Lautaro-De-Lucia/doc-final-electroacustica/Fuentes/Electroacústica_Completo-284-322.pdf

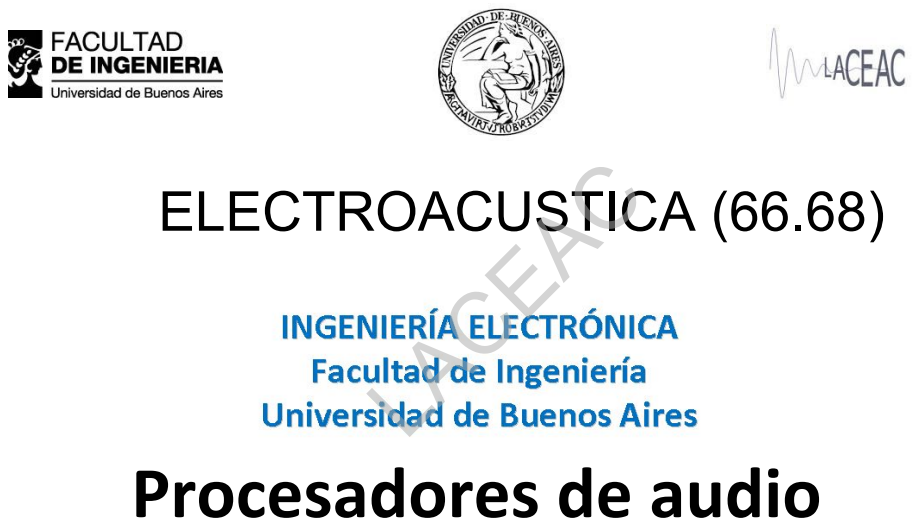
[picture p139: page 1]
ELECTROACUSTICA (66.68); LACEAC

# Gain

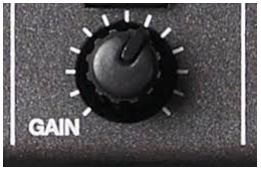
[picture p140: figure]
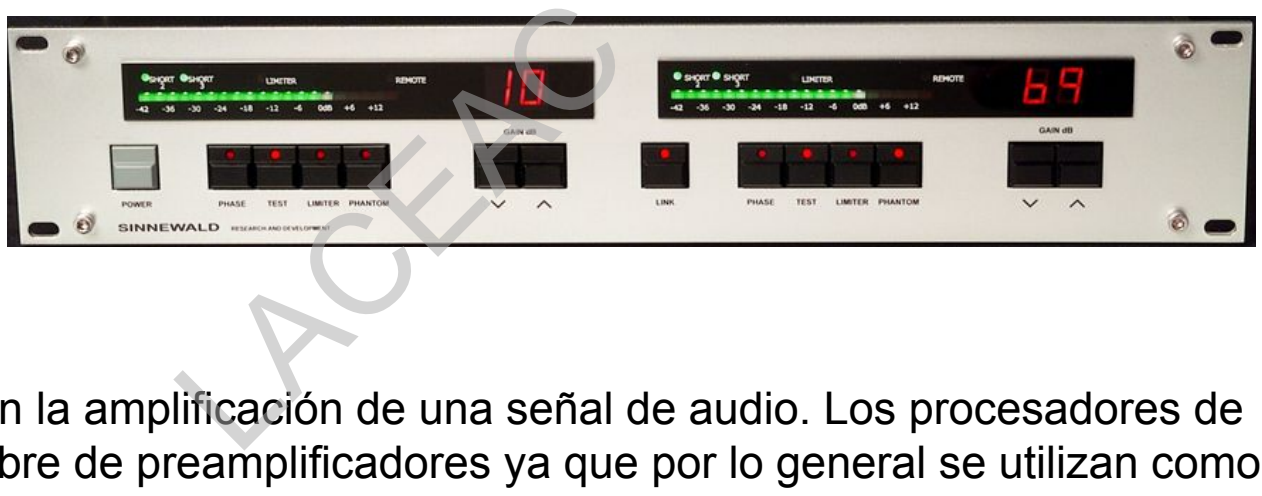
[picture p141: figure]
LACEAC

Consiste simplemente en la amplificación de una señal de audio. Los procesadores de este tipo reciben el nombre de preamplificadores ya que por lo general se utilizan como inicio de la cadena de audio para obtener el nivel de señal de deseado para su posterior procesamiento. Debe tenerse en cuenta que debido a que no existe el amplificador ideal, este proceso introducirá indefectiblemente distorsión armónica y ruido en la señal.

# Suma o “Mezcla”

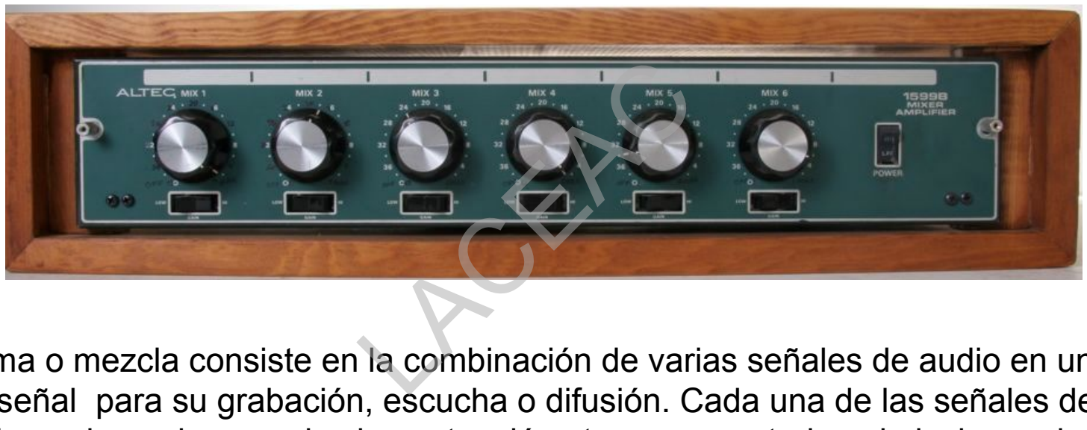
[picture p142: figure]
LACEAC

La suma o mezcla consiste en la combinación de varias señales de audio en una única señal para su grabación, escucha o difusión. Cada una de las señales de entrada se denomina canal, y los potenciómetros que controlan el nivel con el que se suma a la señal de salida se denominan faders. En el caso de una señal de salida stereo mediante un potenciómetro llamado pan también se controla el nivel enviado a cada canal de salida para controlar la imagen virtual generada.

# Suma o “Mezcla”

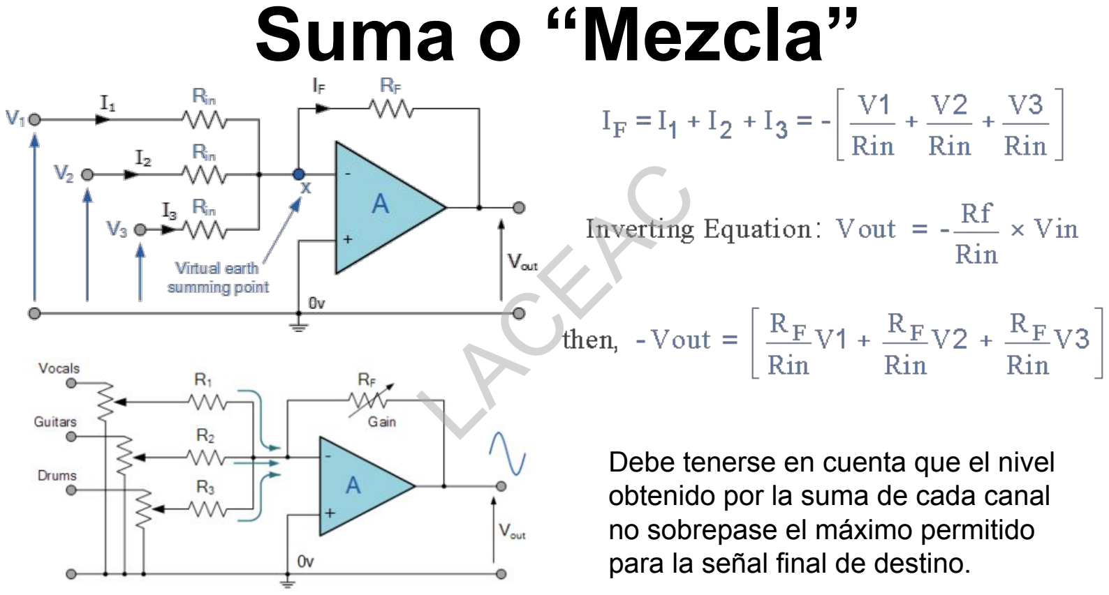
[picture p143: page 4]

Debe tenerse en cuenta que el nivel obtenido por la suma de cada canal no sobrepase el máximo permitido para la señal final de destino.

# LACEAC

# Suma o “Mezcla”

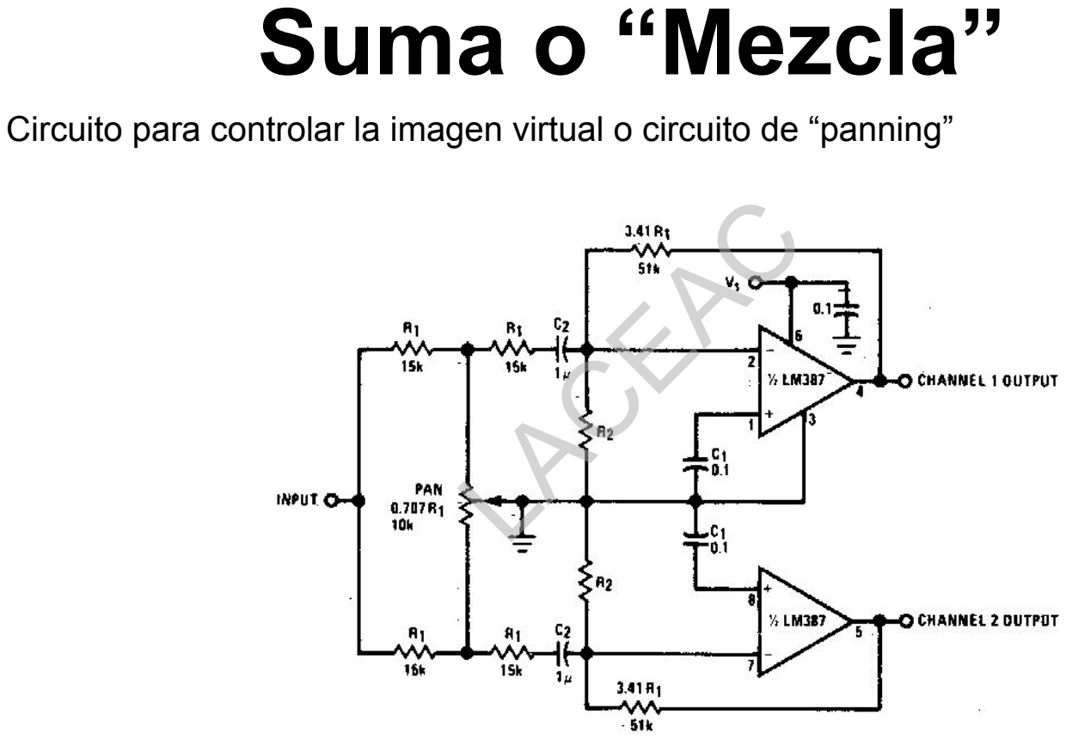
[picture p144: page 5]

Circuito para controlar la imagen virtual o circuito de “panning”

# LACEAC

EQ

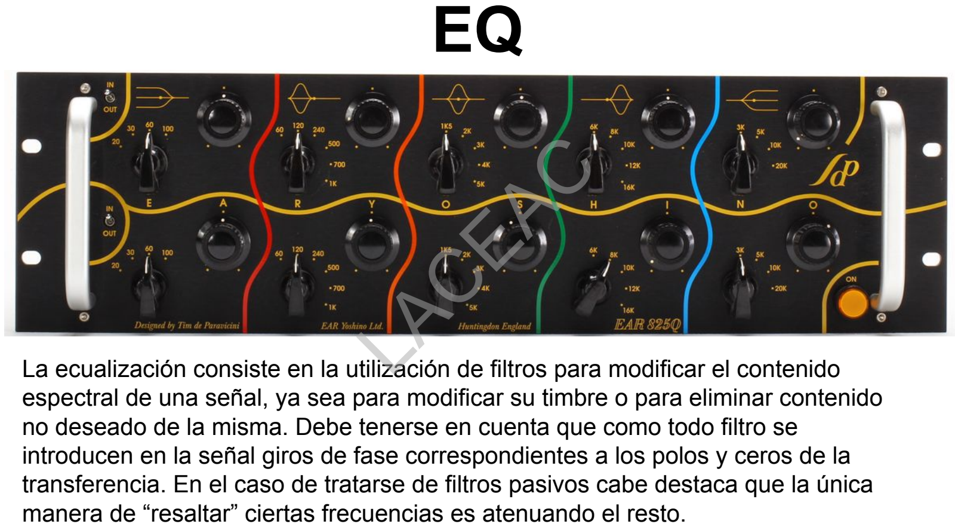
[picture p145: page 6]

La ecualización consiste en la utilización de filtros para modificar el contenido espectral de una señal, ya sea para modificar su timbre o para eliminar contenido no deseado de la misma. Debe tenerse en cuenta que como todo filtro se introducen en la señal giros de fase correspondientes a los polos y ceros de la transferencia. En el caso de tratarse de filtros pasivos cabe destaca que la única manera de “resaltar” ciertas frecuencias es atenuando el resto.

# LACEAC

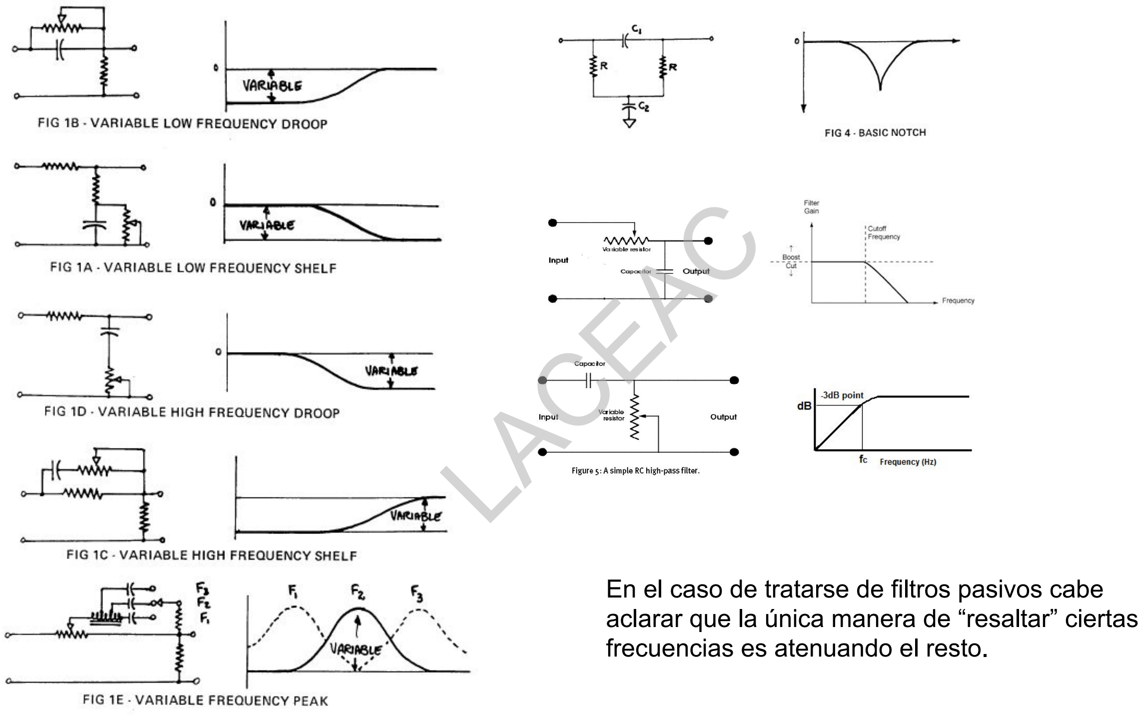
[picture p146: page 7]

En el caso de tratarse de filtros pasivos cabe aclarar que la única manera de “resaltar” ciertas frecuencias es atenuando el resto.

# LACEAC

# Ecualizador paramétrico

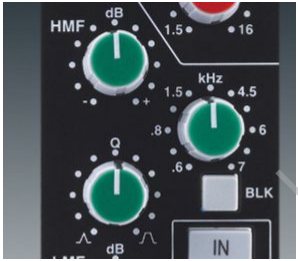
[picture p147: figure]

En un ecualizador paramétrico la frecuencia de corte, la ganancia y factor de mérito son variables. Por limitaciones constructivas el rango de operación suele ser limitado.

# LACEAC

# Ecualizador paramétrico

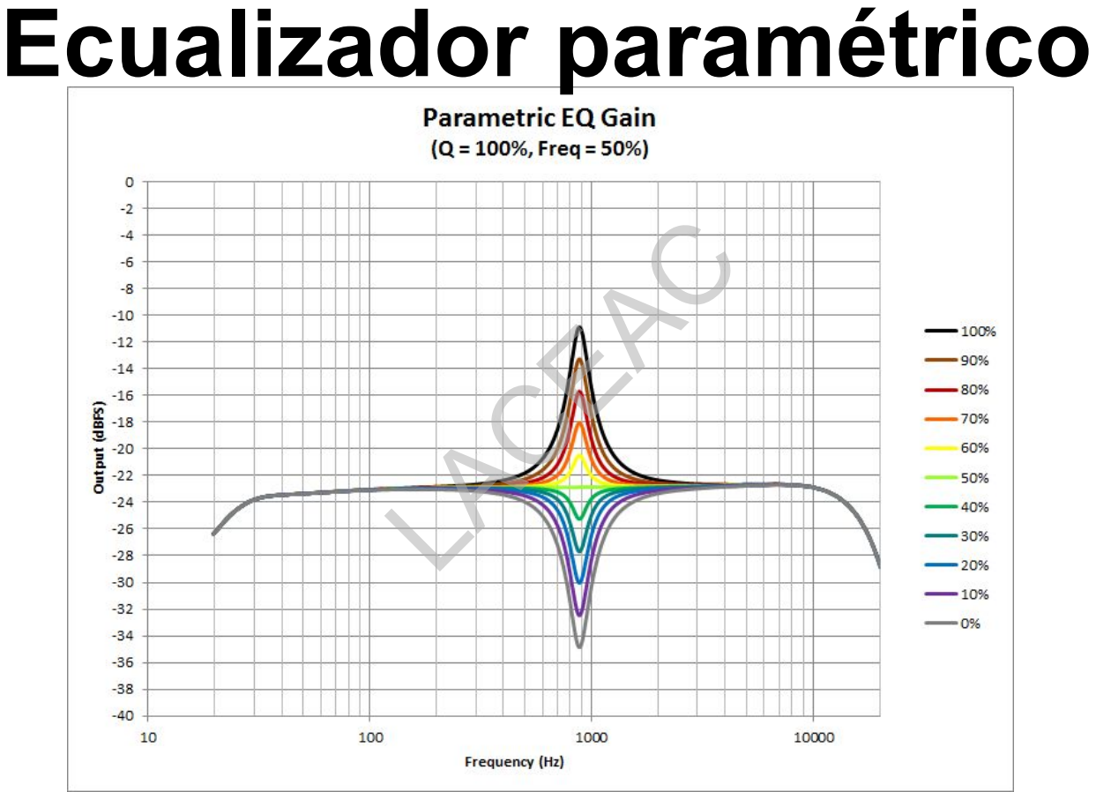
[picture p148: page 9]

# LACEAC

# Ecualizador paramétrico

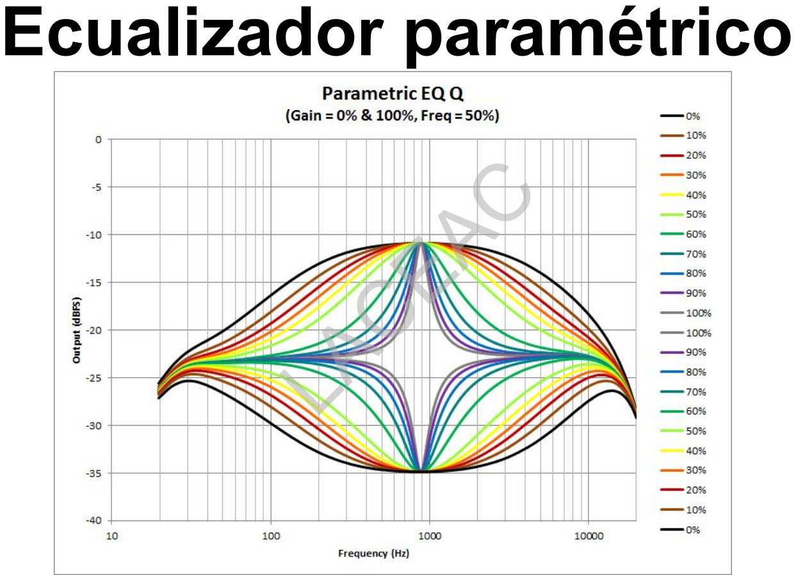
[picture p149: page 10]

# LACEAC

# Ecualizador paramétrico

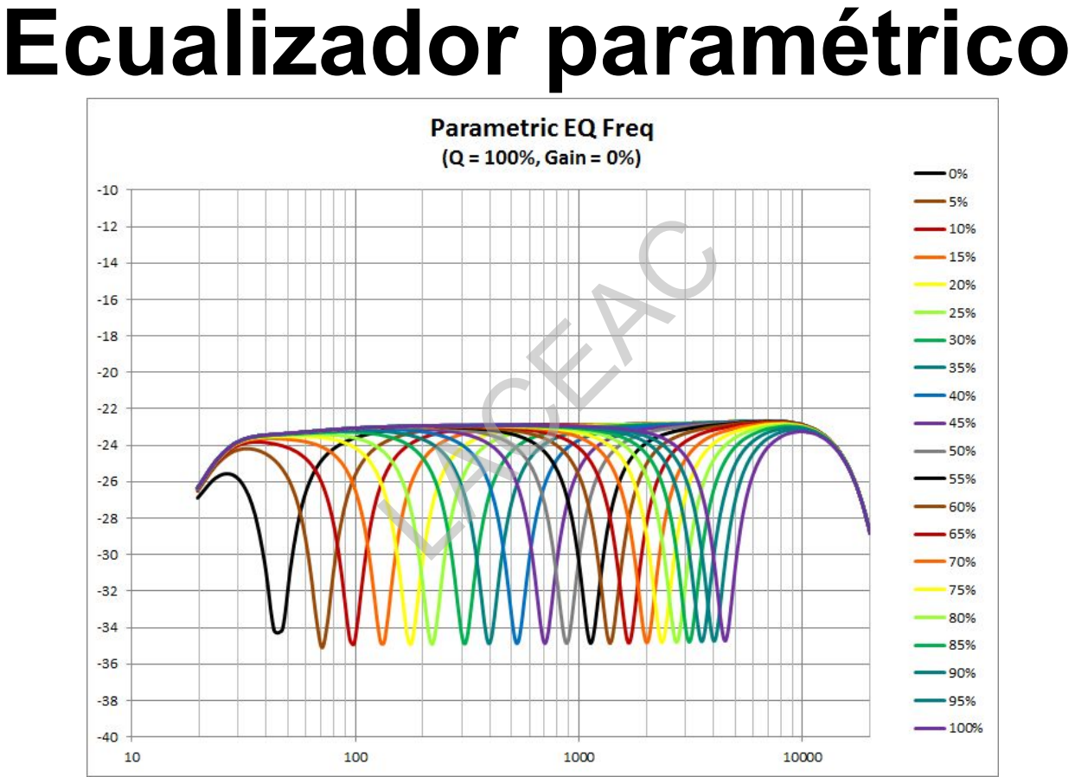
[picture p150: page 11]

# LACEAC

# Wah-Wah

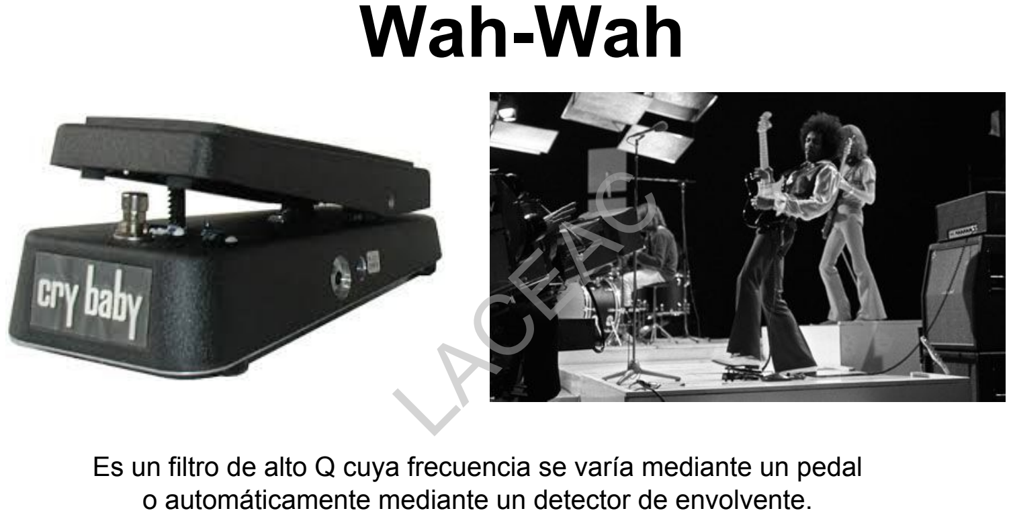
[picture p151: page 12]

Es un filtro de alto Q cuya frecuencia se varía mediante un pedal o automáticamente mediante un detector de envolvente.

# LACEAC

# Ecualizador Gráfico

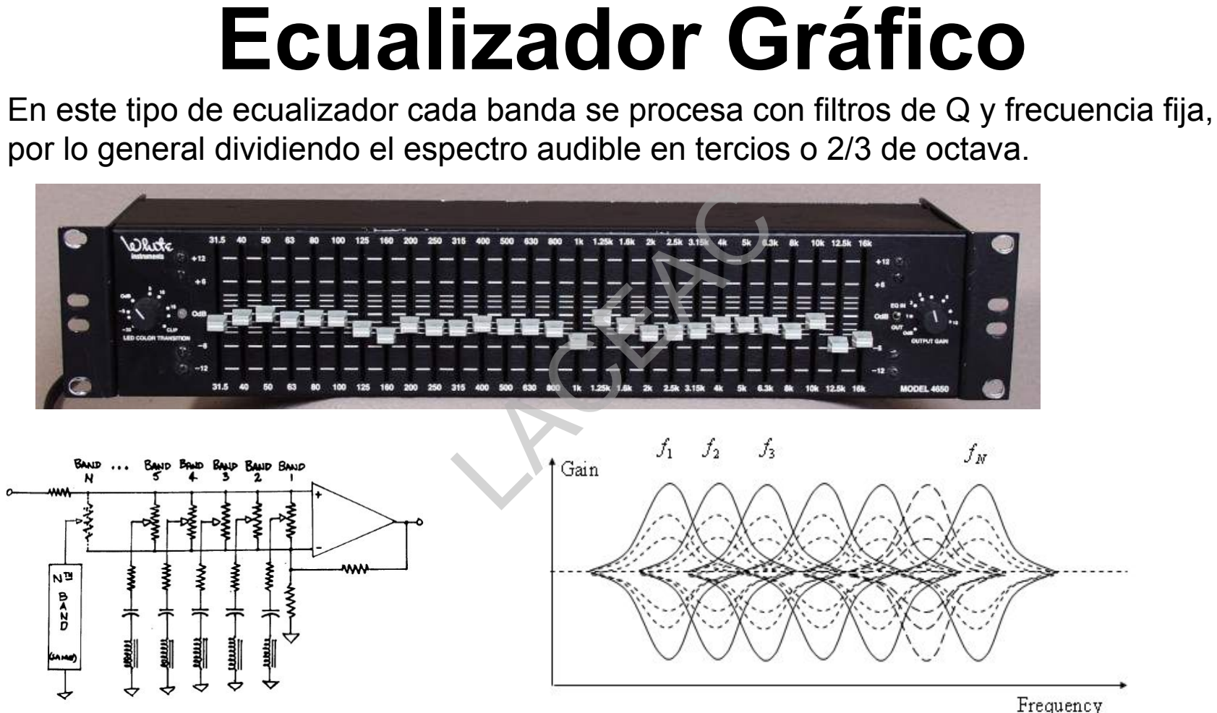
[picture p152: page 13]

En este tipo de ecualizador cada banda se procesa con filtros de Q y frecuencia fija, por lo general dividiendo el espectro audible en tercios o 2/3 de octava.

# LACEAC

# Consola o mixer

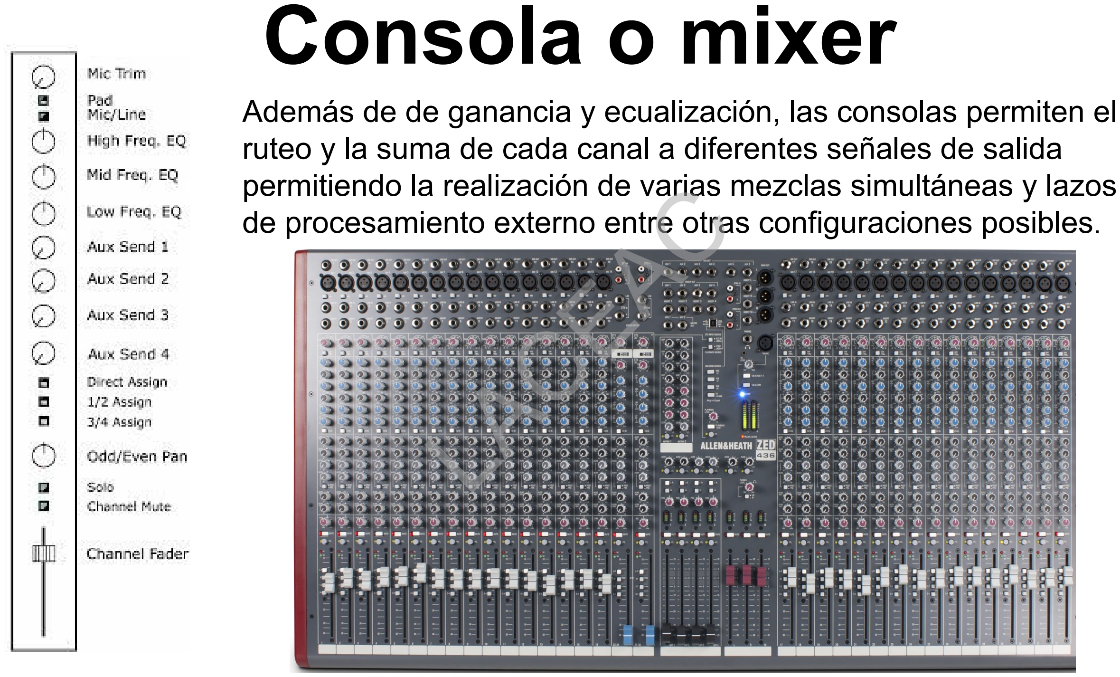
[picture p153: page 14]

Además de de ganancia y ecualización, las consolas permiten el ruteo y la suma de cada canal a diferentes señales de salida permitiendo la realización de varias mezclas simultáneas y lazos de procesamiento externo entre otras configuraciones posibles.

# LACEAC

El efecto de chorus es un proceso de modulación que emula el pequeño movimiento en tiempo y afinación que se genera entre 2 o más ejecutantes de un coro cantando al unísono.Para generar este efecto a la señal original se le suma una copia con un delay variable modulado por un LFO de aproximadamente 5 a 40 ms . El delay está implementado mediante la modulación de la frecuencia de clock de una línea de retardo analógica mediante el uso de celdas BBD (bucket brigade device) de manera que las pequeñas variaciones de delay también introducen variaciones de afinación.

# Chorus

# LACEAC

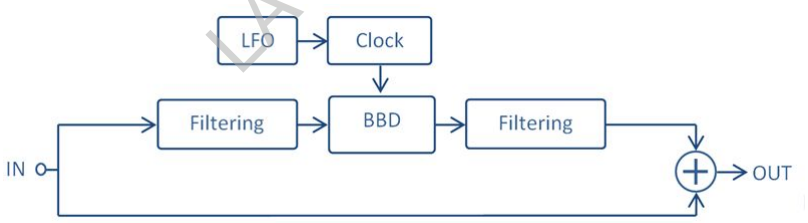
[picture p154: figure]

# Flanger

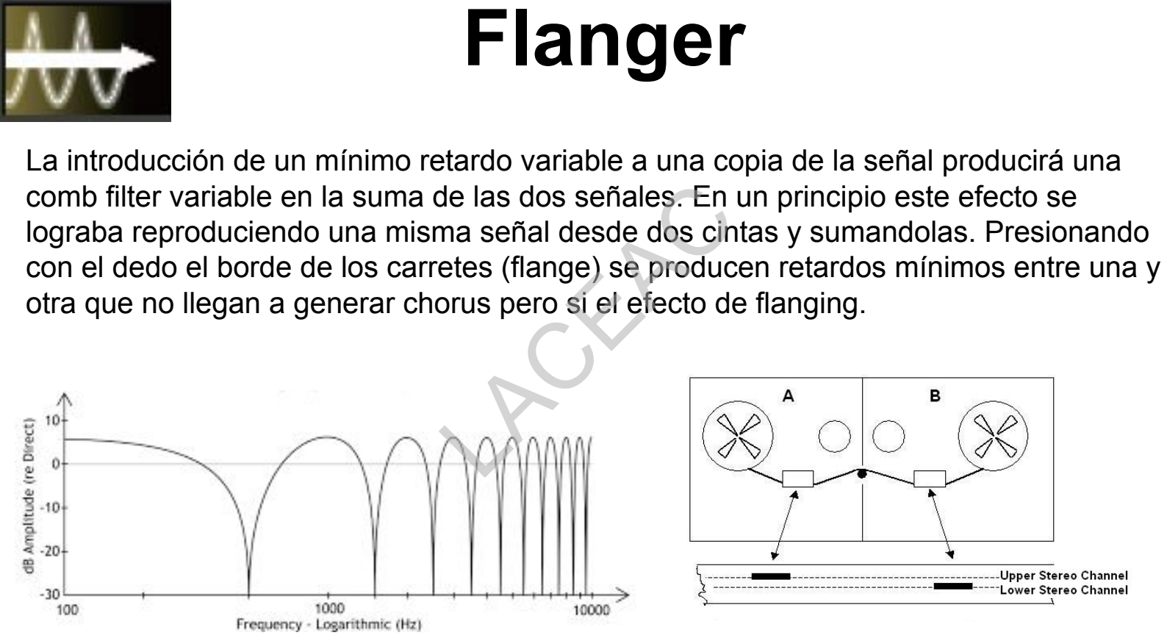
[picture p155: page 16]

La introducción de un mínimo retardo variable a una copia de la señal producirá una comb filter variable en la suma de las dos señales. En un principio este efecto se lograba reproduciendo una misma señal desde dos cintas y sumandolas. Presionando con el dedo el borde de los carretes (flange) se producen retardos mínimos entre una y otra que no llegan a generar chorus pero si el efecto de flanging.

# LACEAC

# Flanger

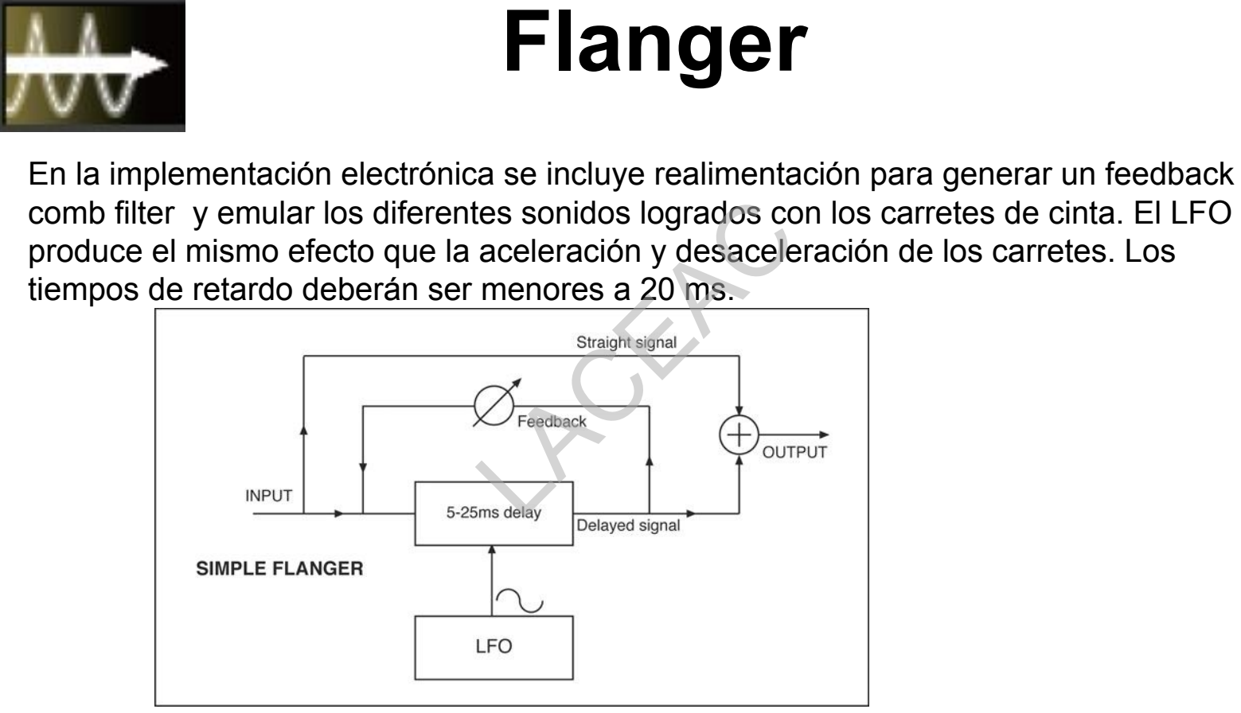
[picture p156: page 17]

En la implementación electrónica se incluye realimentación para generar un feedback comb filter y emular los diferentes sonidos logrados con los carretes de cinta. El LFO produce el mismo efecto que la aceleración y desaceleración de los carretes. Los tiempos de retardo deberán ser menores a 20 ms.

# LACEAC

# Phaser

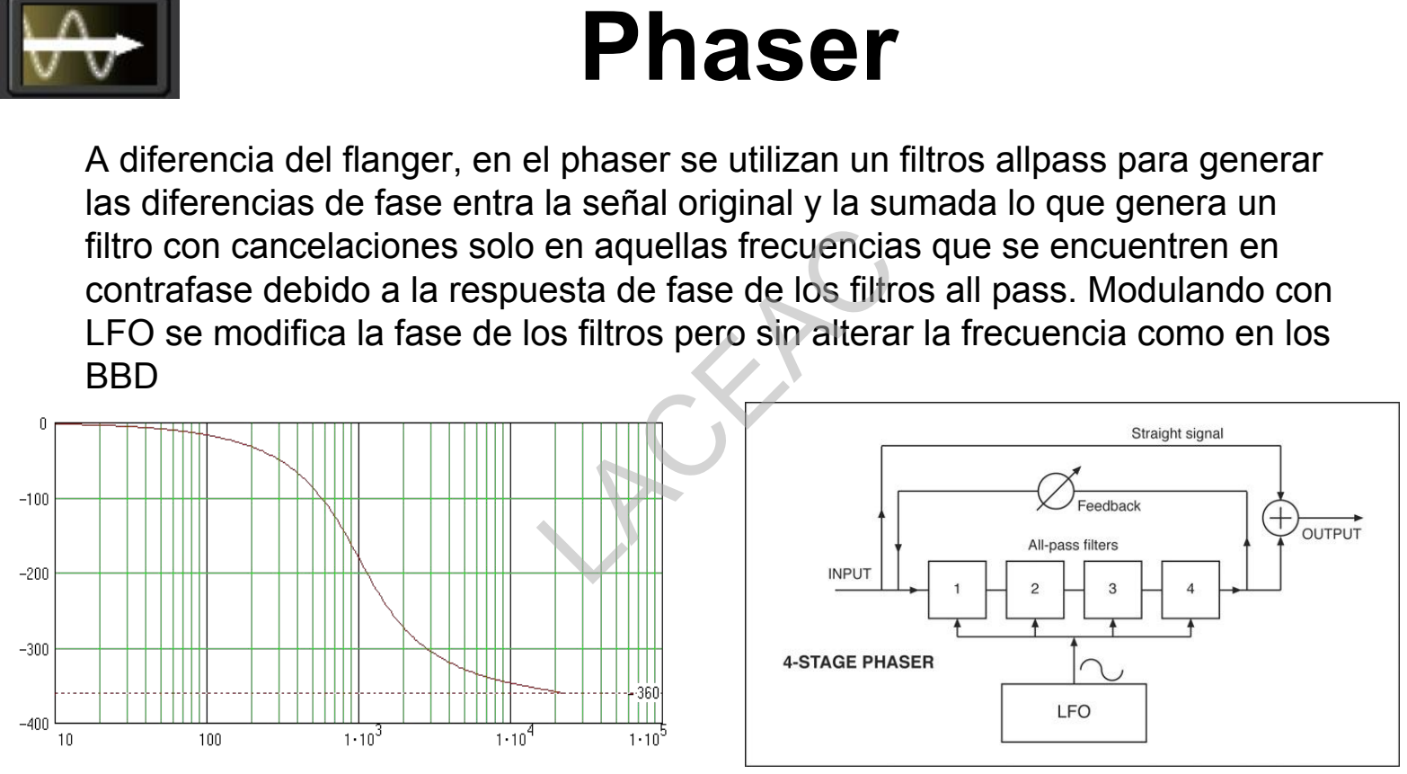
[picture p157: page 18]

A diferencia del flanger, en el phaser se utilizan un filtros allpass para generar las diferencias de fase entra la señal original y la sumada lo que genera un filtro con cancelaciones solo en aquellas frecuencias que se encuentren en contrafase debido a la respuesta de fase de los filtros all pass. Modulando con LFO se modifica la fase de los filtros pero sin alterar la frecuencia como en los BBD

# LACEAC

# Phaser

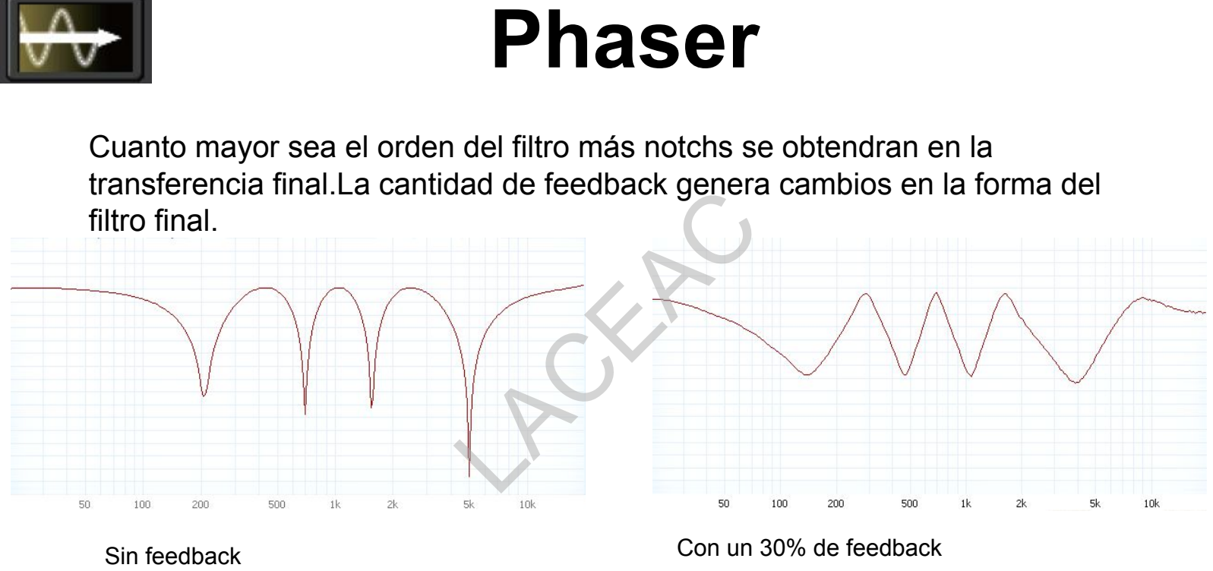
[picture p158: page 19]

Cuanto mayor sea el orden del filtro más notchs se obtendran en la transferencia final.La cantidad de feedback genera cambios en la forma del filtro final.

Sin feedback | Con un 30% de feedback

# LACEAC

# Reverb

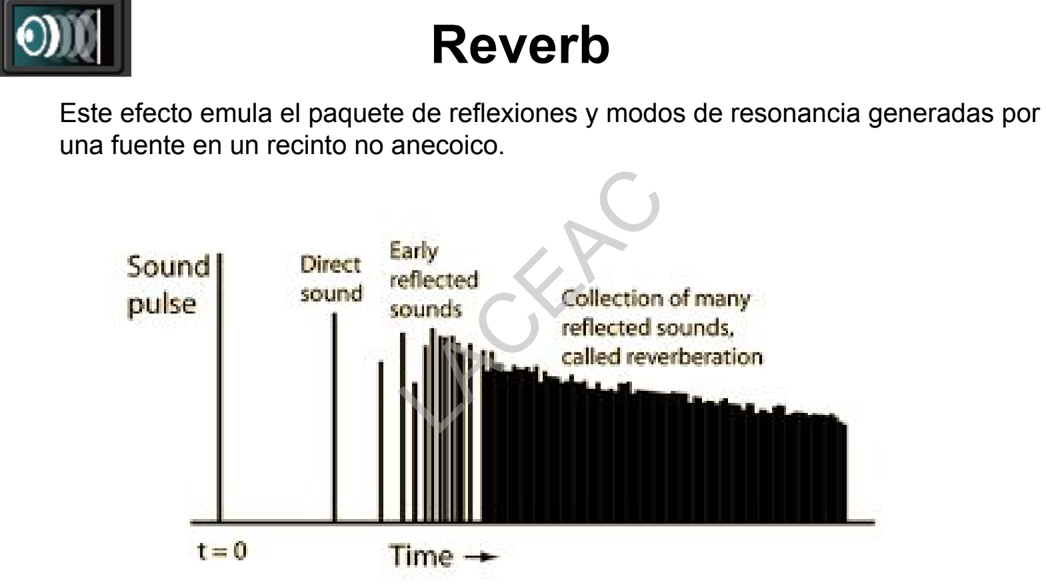
[picture p159: page 20]

Este efecto emula el paquete de reflexiones y modos de resonancia generadas por una fuente en un recinto no anecoico.

# LACEAC

# Reverb Chamber

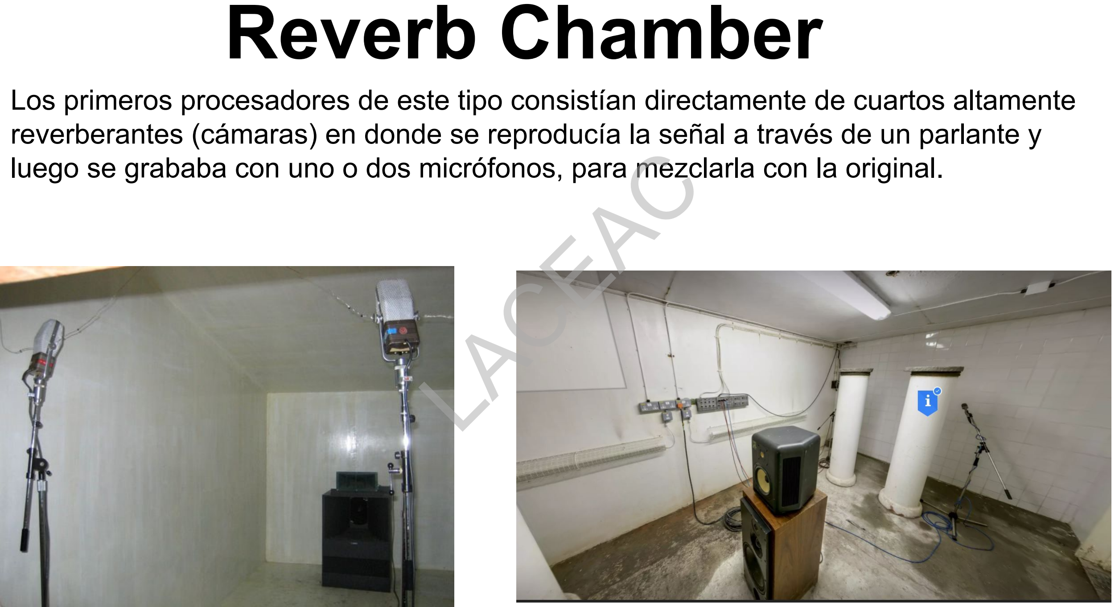
[picture p160: page 21]

Los primeros procesadores de este tipo consistían directamente de cuartos altamente reverberantes (cámaras) en donde se reproducía la señal a través de un parlante y luego se grababa con uno o dos micrófonos, para mezclarla con la original.

# LACEAC

# Plate Reverb

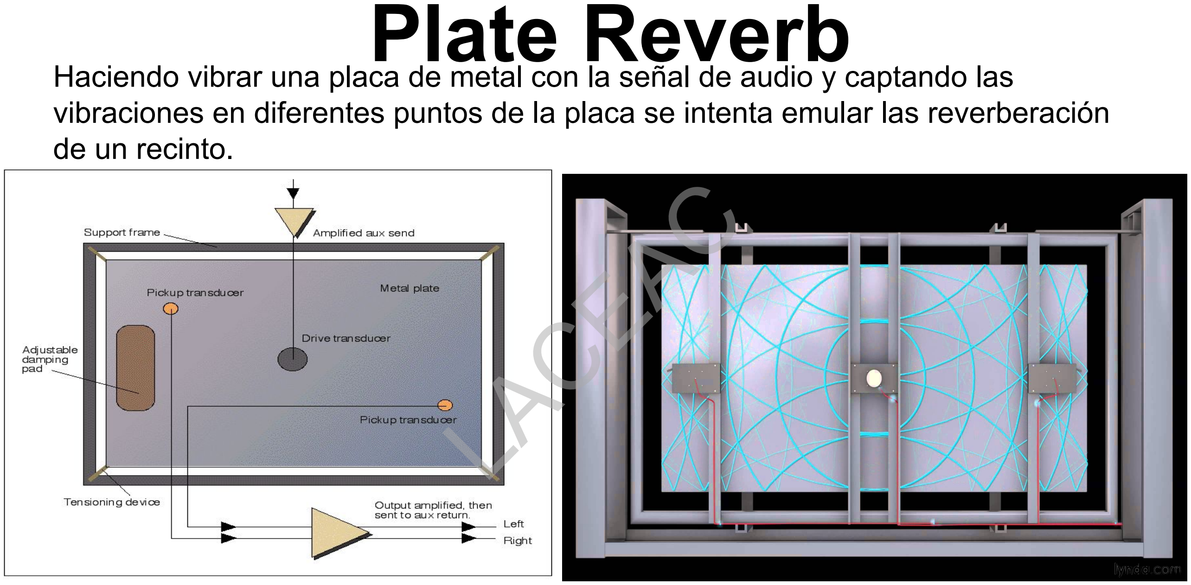
[picture p161: page 22]

Haciendo vibrar una placa de metal con la señal de audio y captando las vibraciones en diferentes puntos de la placa se intenta emular las reverberación de un recinto.

# LACEAC

# Reverb de resorte

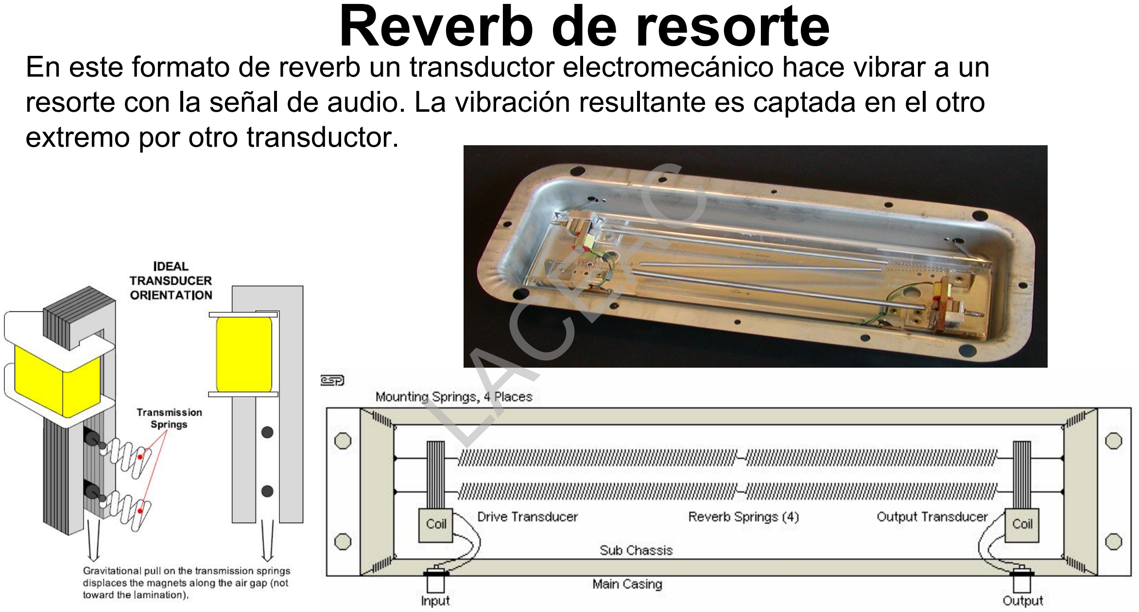
[picture p162: page 23]

En este formato de reverb un transductor electromecánico hace vibrar a un resorte con la señal de audio. La vibración resultante es captada en el otro extremo por otro transductor.

# LACEAC

# Reverb de Schroeder

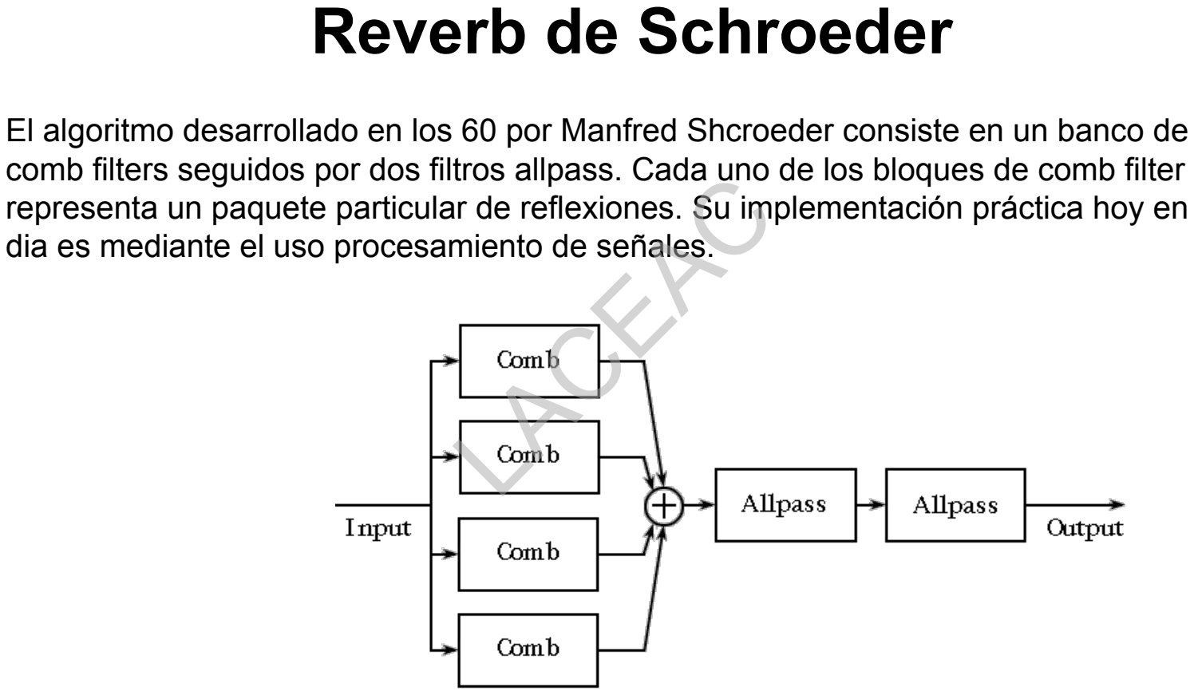
[picture p163: page 24]

El algoritmo desarrollado en los 60 por Manfred Shcroeder consiste en un banco de comb filters seguidos por dos filtros allpass. Cada uno de los bloques de comb filter representa un paquete particular de reflexiones. Su implementación práctica hoy en dia es mediante el uso procesamiento de señales.

# LACEAC

Si bien el bloque final es el de un comb filter resulta más sencillo verlo como una copia con retardo de la señal cuya amplitud va disminuyendo exponencialmente con el tiempo de reverberación deseado. Los tiempos de cada banco se eligen utilizando números primos de manera que no se solapen las reflexiones.Los dos filtros all pass se implementan de manera de modificar la fase de las diferentes reflexiones tal como pasaría en un recinto real.

# Reverb de Schroeder

# LACEAC

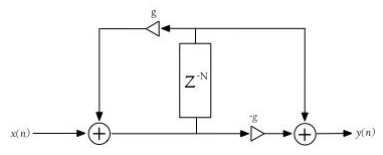
[picture p164: figure]

# Reverb de Moorer

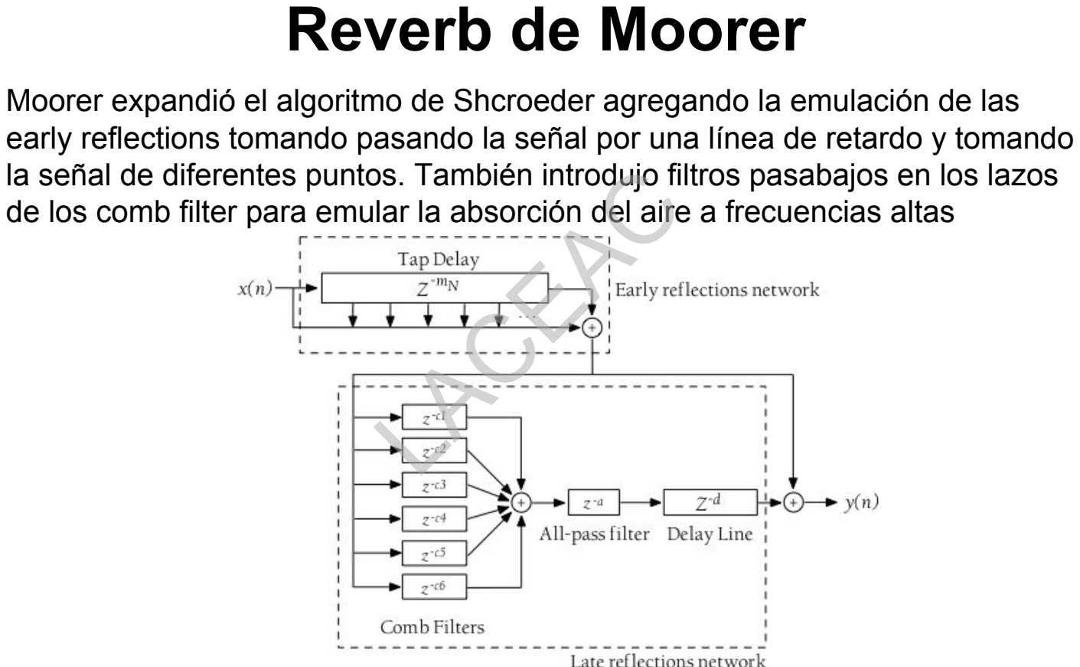
[picture p165: page 26]

Moorer expandió el algoritmo de Shcroeder agregando la emulación de las early reflections tomando pasando la señal por una línea de retardo y tomando la señal de diferentes puntos. También introdujo filtros pasabajos en los lazos de los comb filter para emular la absorción del aire a frecuencias altas

# LACEAC

# Reverb de Convolución

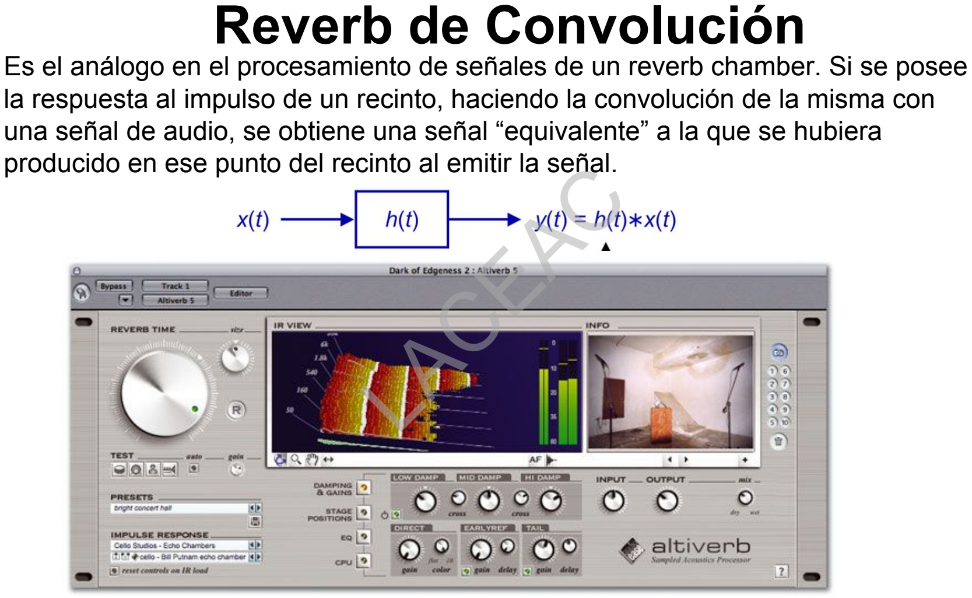
[picture p166: page 27]

Es el análogo en el procesamiento de señales de un reverb chamber. Si se posee la respuesta al impulso de un recinto, haciendo la convolución de la misma con una señal de audio, se obtiene una señal “equivalente” a la que se hubiera producido en ese punto del recinto al emitir la señal.

# LACEAC

# Tremolo

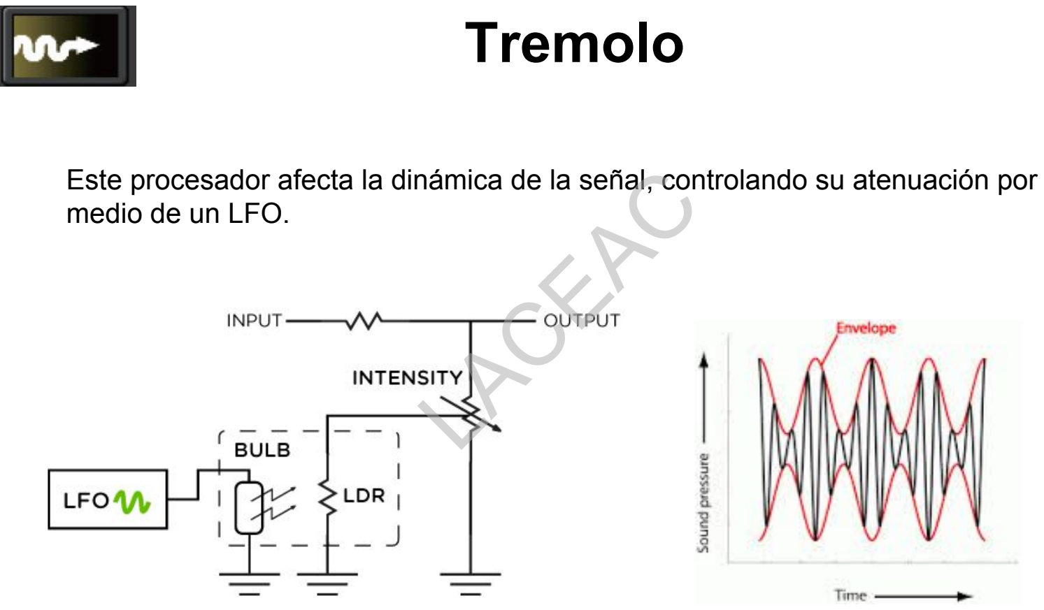
[picture p167: page 28]

Este procesador afecta la dinámica de la señal, controlando su atenuación por medio de un LFO.

# LACEAC

# Rotary Speaker

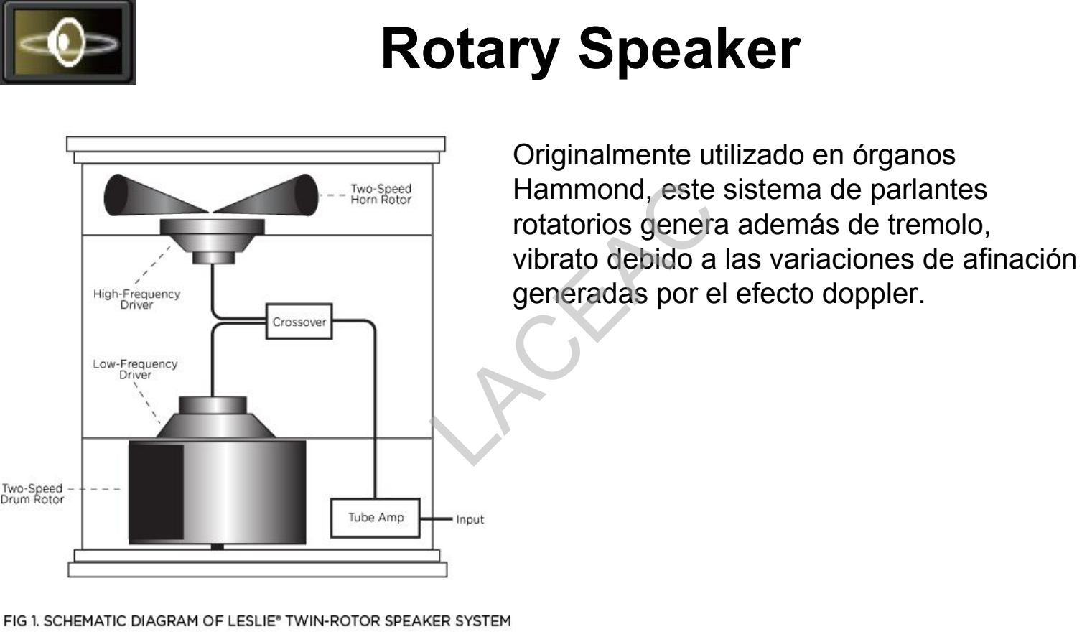
[picture p168: page 29]

Originalmente utilizado en órganos Hammond, este sistema de parlantes rotatorios genera además de tremolo, vibrato debido a las variaciones de afinación generadas por el efecto doppler.

# LACEAC

# Rotary Speaker

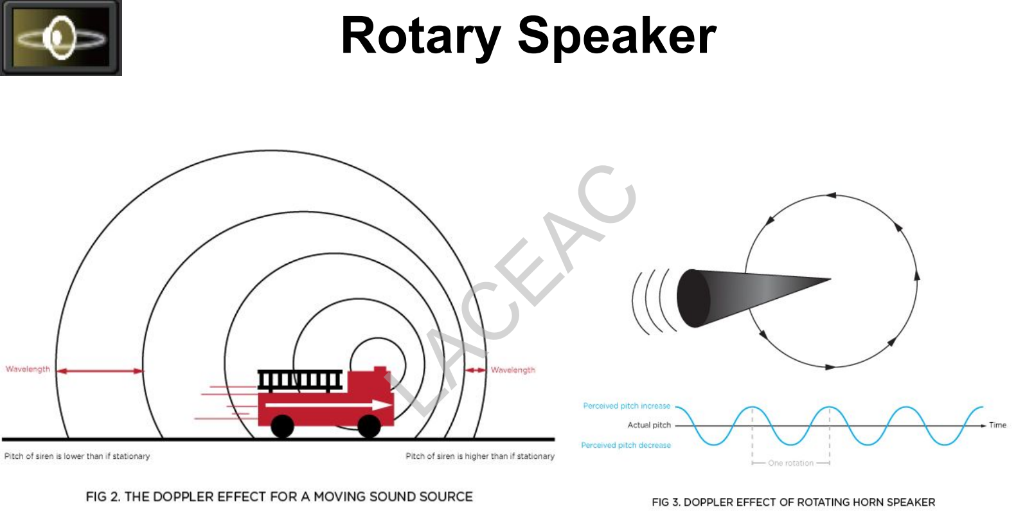
[picture p169: page 30]

# LACEAC

# Delay

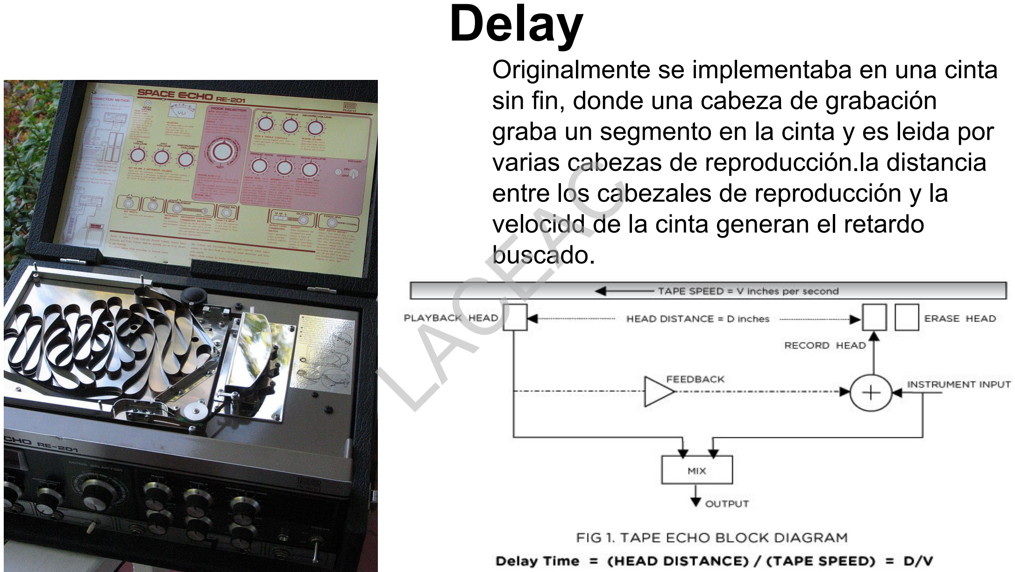
[picture p170: page 31]

Originalmente se implementaba en una cinta sin fin, donde una cabeza de grabación graba un segmento en la cinta y es leida por varias cabezas de reproducción.la distancia entre los cabezales de reproducción y la velocidd de la cinta generan el retardo buscado.

# LACEAC

Este efecto consiste en generar copias con retardo de la señal original de manera de escuchar un eco. Utilizando BDD se implementan líneas con retardo programable. Mediante el uso de feedback se logra controlar la cantidad de repeticiones regulando la atenuación de las mismas.

# Delay

# LACEAC

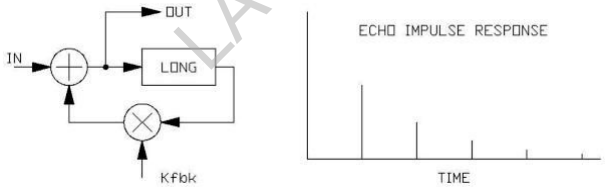
[picture p171: figure]

# Ring Modulator

Este procesador funciona como un multiplicador analógico generando las componentes de heterodinación de las dos señales. Aplicado a la señal de audio genera un sonido generalmente “metálico”. Este principio se utilizó, filtrando algunas componentes en especial,para lograr los diferentes sonidos en los primeros sintetizadores analógicos.

# LACEAC

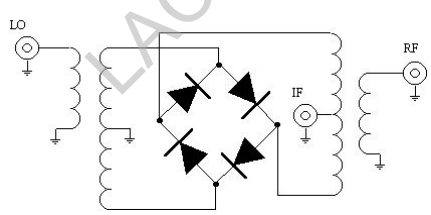
[picture p172: figure]

# Distorsión

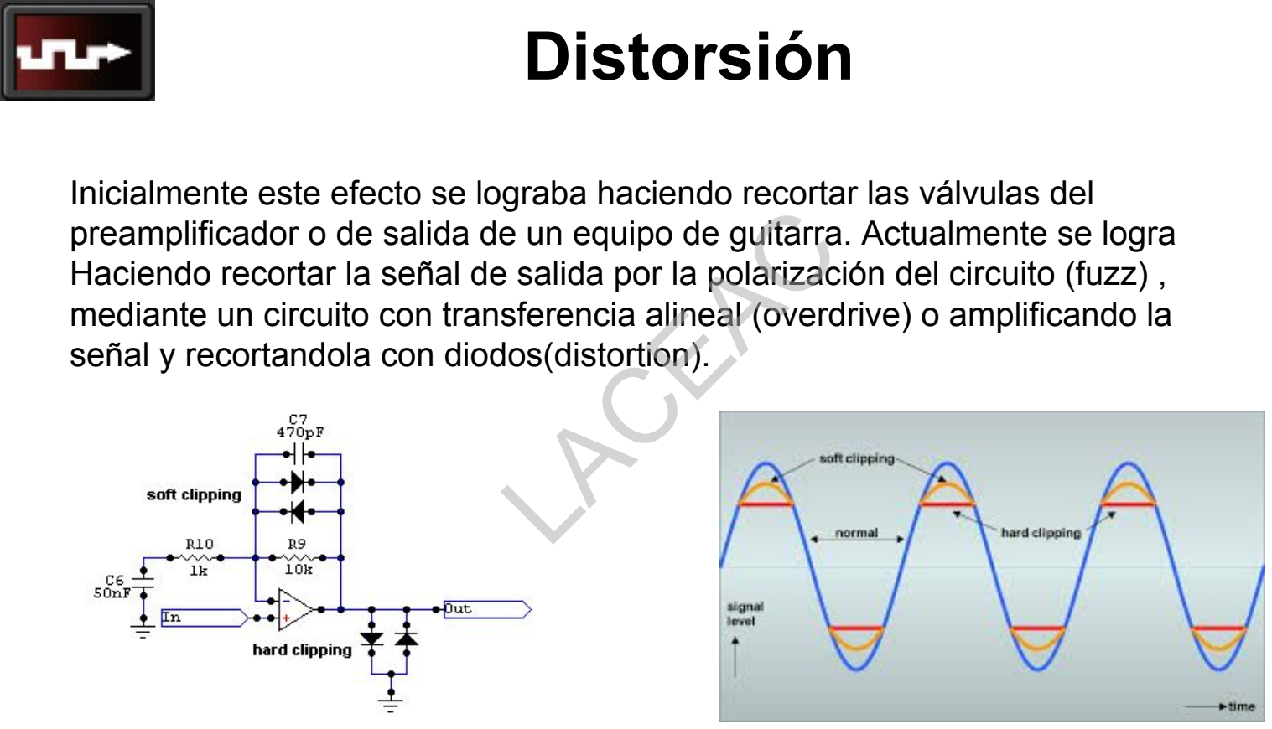
[picture p173: page 34]

Inicialmente este efecto se lograba haciendo recortar las válvulas del preamplificador o de salida de un equipo de guitarra. Actualmente se logra Haciendo recortar la señal de salida por la polarización del circuito (fuzz) , mediante un circuito con transferencia alineal (overdrive) o amplificando la señal y recortandola con diodos(distortion).

# LACEAC

# Octaver

Utilizando el concepto del multiplicador analogico existen procesadores que obtienen a partir de una señal de audio, otra señal similar cuyas componentes

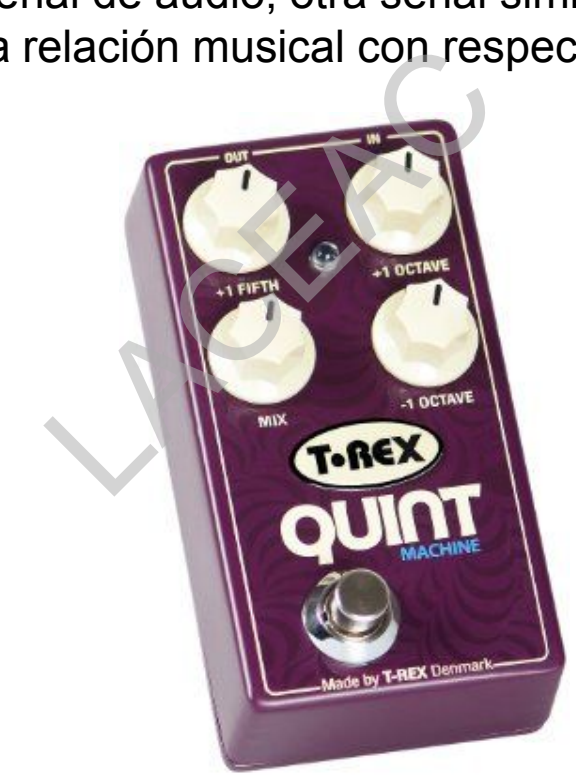
[picture p174: figure]
LACEAC

están desplazadas en una relación musical con respecto a la original.

Para generar una octava por debajo de la fundamental se recurre a un comparador para obtener una señal cuadrada de la frecuencia fundamental y se la divide en un

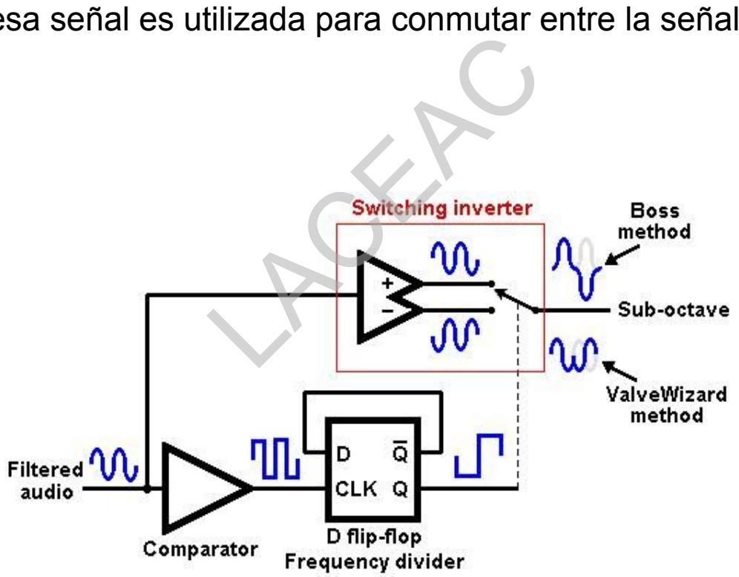
[picture p175: figure]
LACEAC

flip-flop. Luego esa señal es utilizada para conmutar entre la señal original y una copia invertida.

# Octaver

# Vocoder

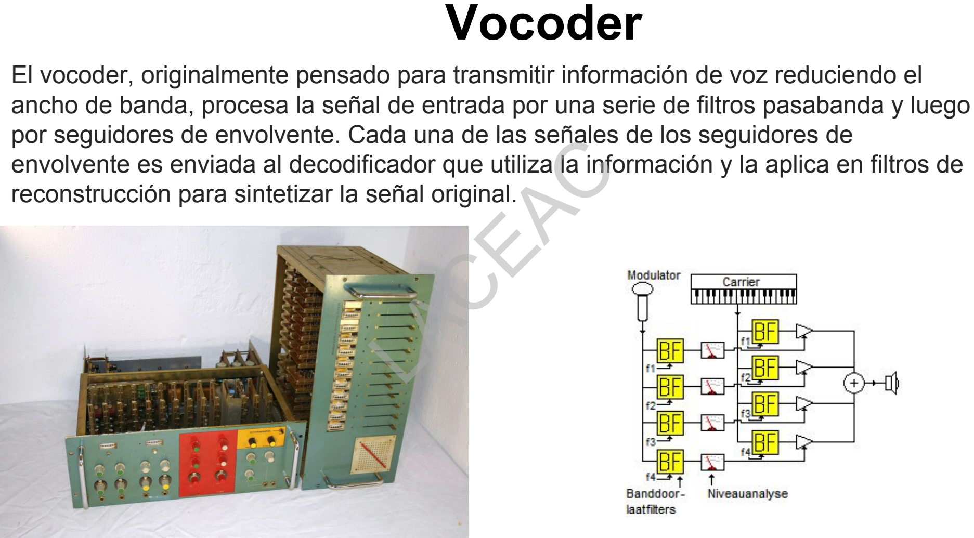
[picture p176: page 37]

El vocoder, originalmente pensado para transmitir información de voz reduciendo el ancho de banda, procesa la señal de entrada por una serie de filtros pasabanda y luego por seguidores de envolvente. Cada una de las señales de los seguidores de envolvente es enviada al decodificador que utiliza la información y la aplica en filtros de reconstrucción para sintetizar la señal original.

# LACEAC

# Compresor dinámico

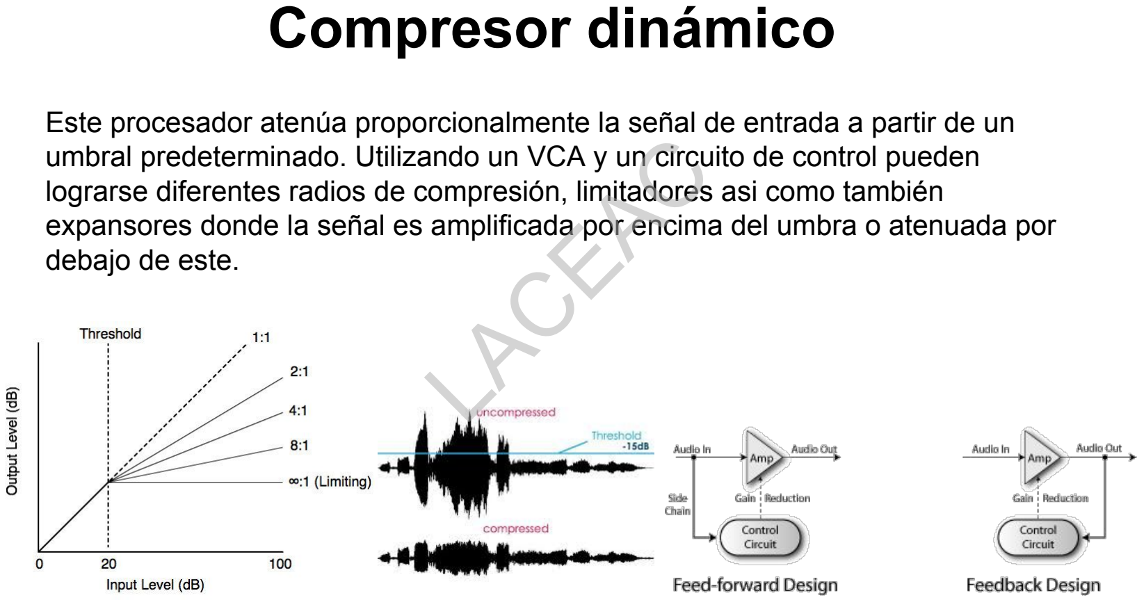
[picture p177: page 38]

Este procesador atenúa proporcionalmente la señal de entrada a partir de un umbral predeterminado. Utilizando un VCA y un circuito de control pueden lograrse diferentes radios de compresión, limitadores asi como también expansores donde la señal es amplificada por encima del umbra o atenuada por debajo de este.

# LACEAC

# Gate

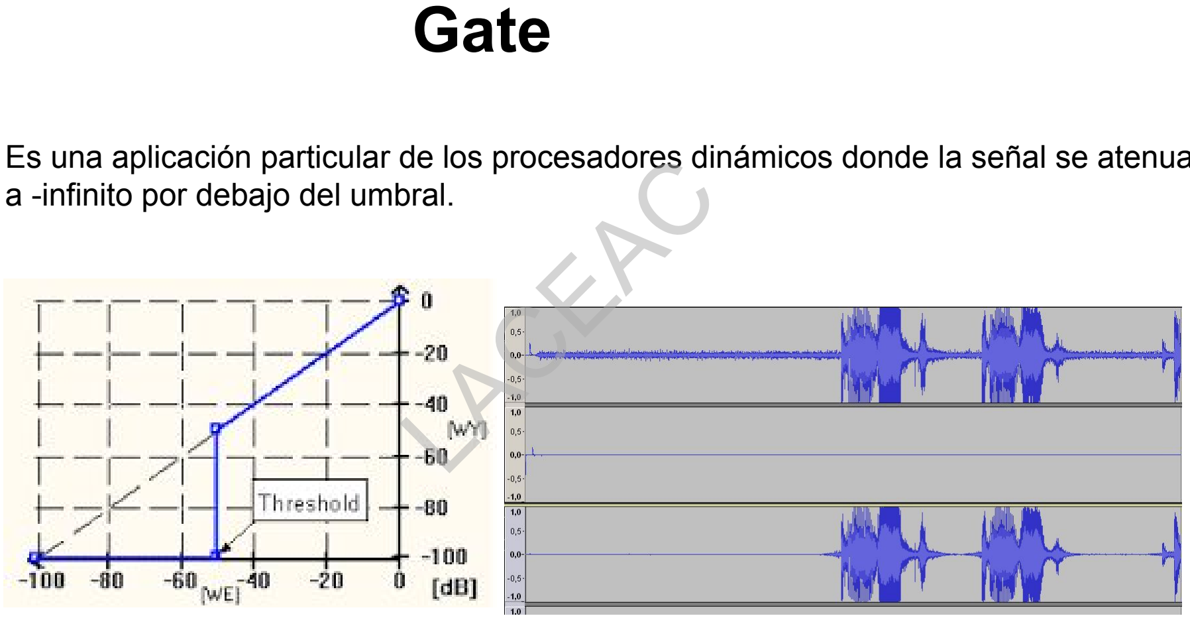
[picture p178: page 39]

Es una aplicación particular de los procesadores dinámicos donde la señal se atenua a -infinito por debajo del umbral.

# LACEAC
