Lautaro-De-Lucia/doc-final-electroacustica/image-3.png

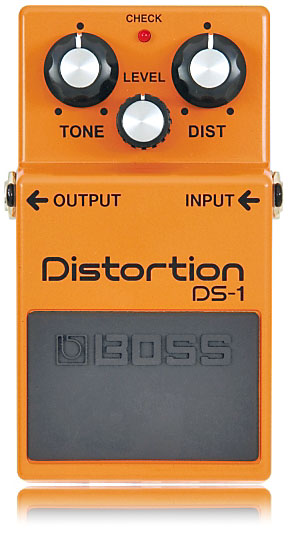
image-3.png
