Lautaro-De-Lucia/doc-final-electroacustica/image-4.png

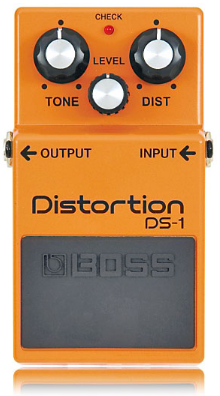
image-4.png
