Lautaro-De-Lucia/doc-final-electroacustica/image-6.png

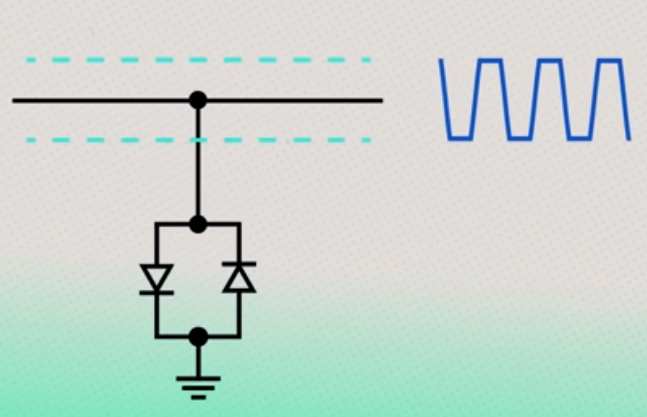
image-6.png
