Lautaro-De-Lucia/doc-final-electroacustica/image-7.png

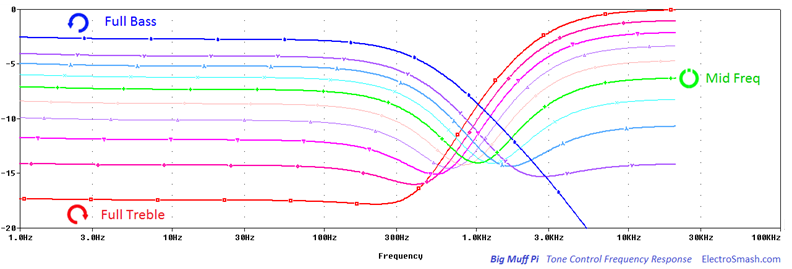
image-7.png
