Lautaro-De-Lucia/doc-final-electroacustica/image-9.png

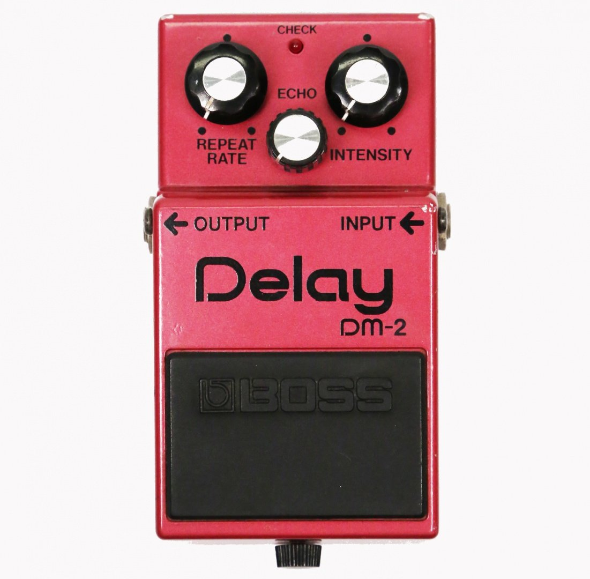
image-9.png
