Lautaro-De-Lucia/doc-final-electroacustica/image-10.png

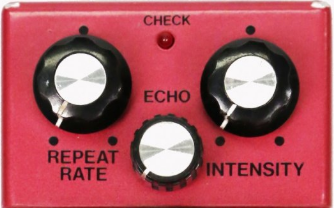
image-10.png
