Lautaro-De-Lucia/doc-final-electroacustica/image-11.png

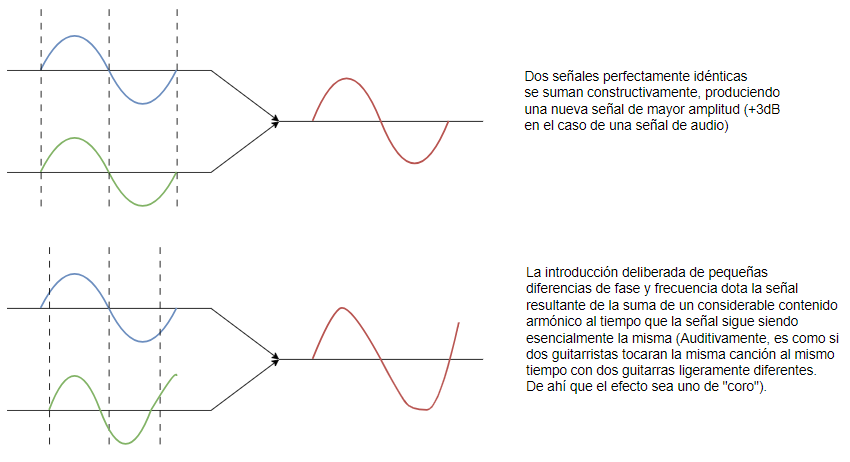
image-11.png
