Lautaro-De-Lucia/doc-final-electroacustica/image-16.png

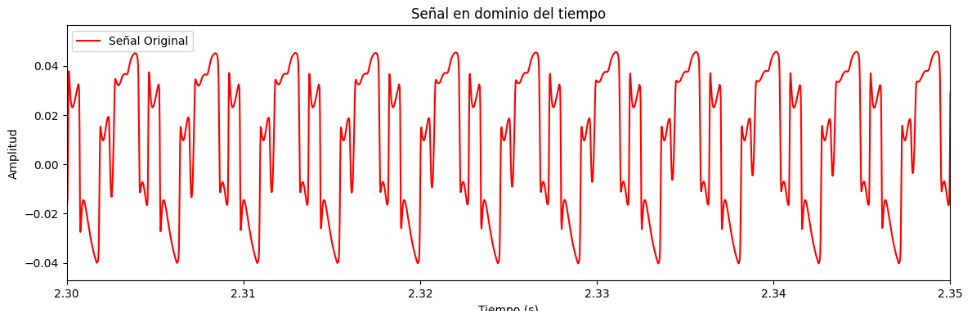
image-16.png
