Lautaro-De-Lucia/doc-final-electroacustica/image-20.png

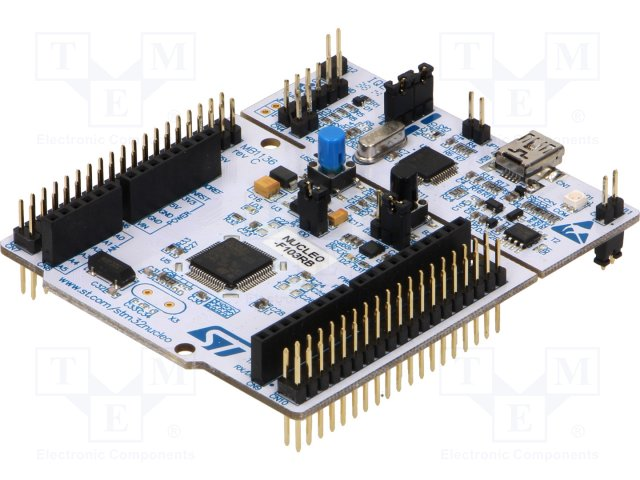
image-20.png
