Lautaro-De-Lucia/doc-final-electroacustica/image-23.png

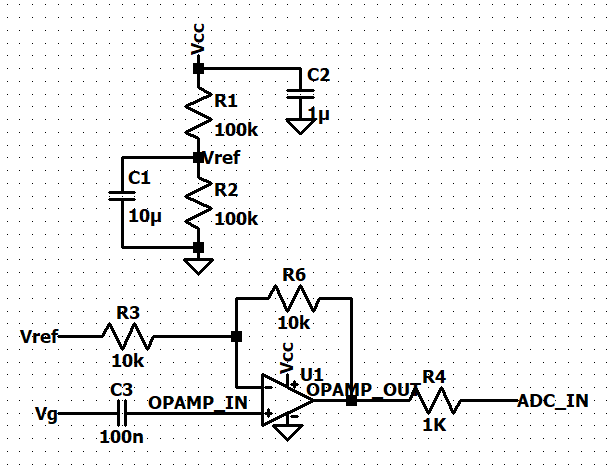
image-23.png
