Lautaro-De-Lucia/doc-final-electroacustica/image-26.png

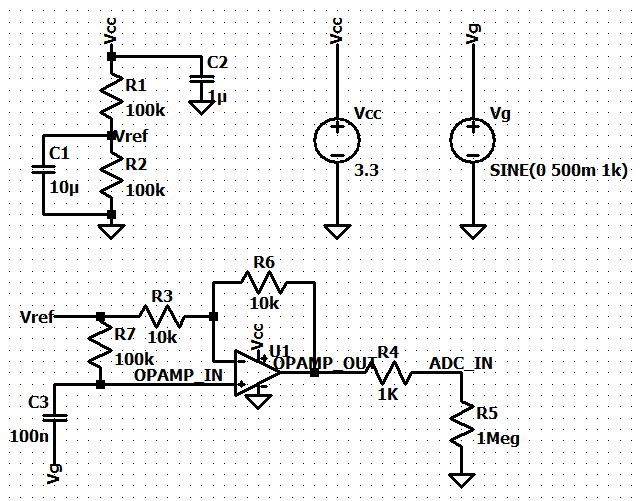
image-26.png
