Lautaro-De-Lucia/doc-final-electroacustica/image-27.png

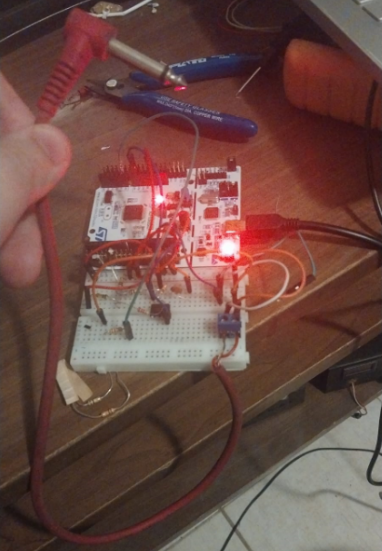
image-27.png
