Lautaro-De-Lucia/doc-final-electroacustica/WhatsApp Image 2025-04-12 at 19.05.21_42ef30f3.jpg

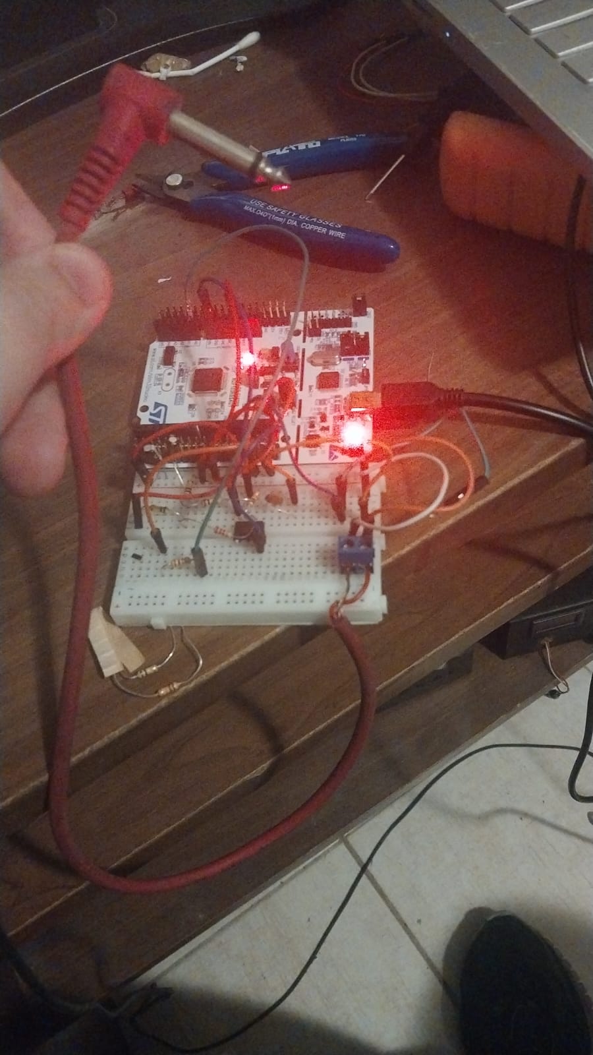
WhatsApp Image 2025-04-12 at 19.05.21_42ef30f3.jpg
