Lautaro-De-Lucia/doc-final-electroacustica/SPICE/Draft1.asc

C1: cap; 10µ
C2: cap; 1µ
C3: cap; 100n
R1: res; 100k
R2: res; 100k
R3: res; 10k
R4: res; 1K
R5: res; 1Meg
R6: res; 10k
R7: res; 100k
U1: UniversalOpAmp
Vcc: voltage; 3.3
Vg: voltage; SINE(0 500m 1k)
Named nets: 0, Vcc, Vg, Vref, OPAMP_IN, OPAMP_OUT, ADC_IN
.tran 5m
.include MCP6001.lib
